mkostrun/QWERTY/art/cupwheel_1_original/PICT0091.jpg

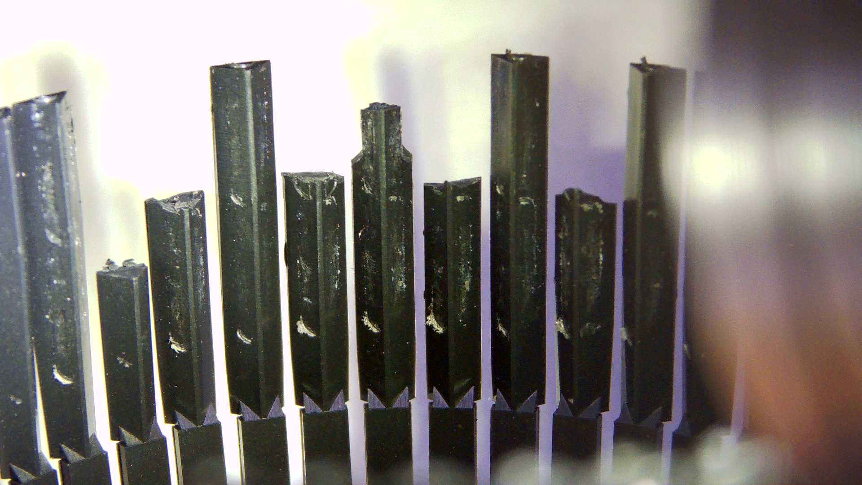
art/cupwheel_1_original/PICT0091.jpg
