mkostrun/QWERTY/art/stm32f030_Nucleo_64_Package_Drawing.jpg

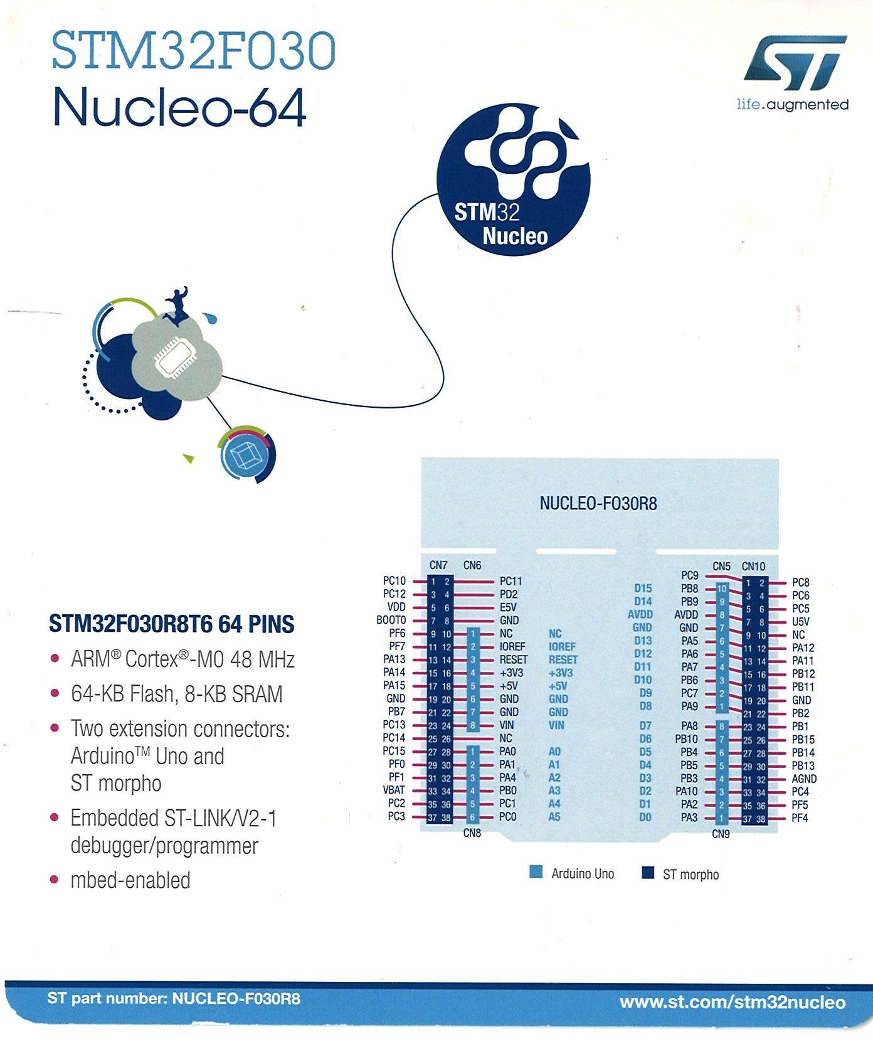
art/stm32f030_Nucleo_64_Package_Drawing.jpg
