mkostrun/QWERTY/art/cupwheel_1_original/PICT0086.jpg

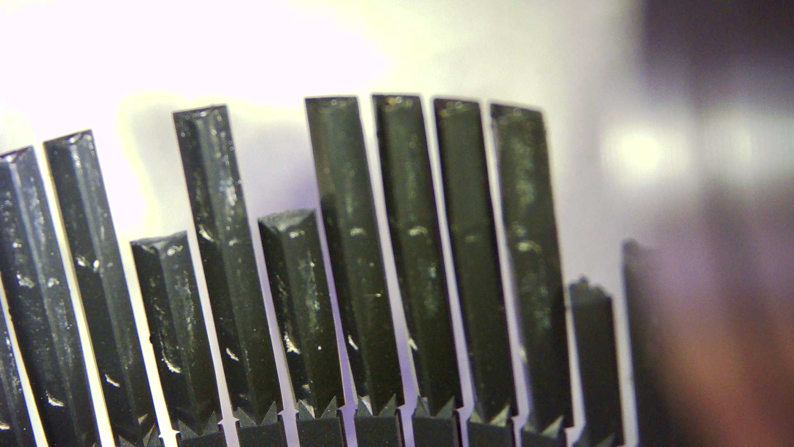
art/cupwheel_1_original/PICT0086.jpg
