mkostrun/QWERTY/art/cupwheel_1_original/PICT0087.jpg

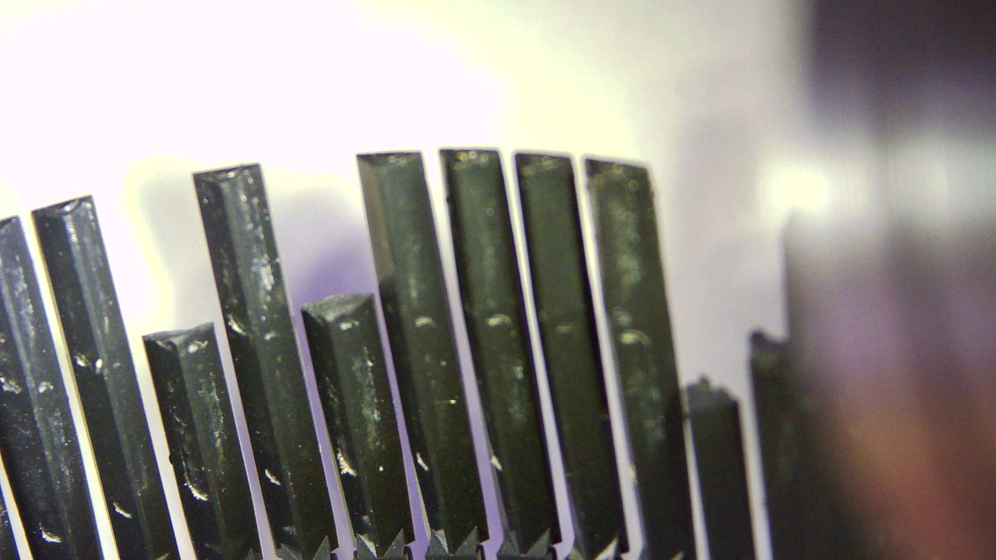
art/cupwheel_1_original/PICT0087.jpg
