mkostrun/QWERTY/art/cupwheel_1_original/PICT0088.jpg

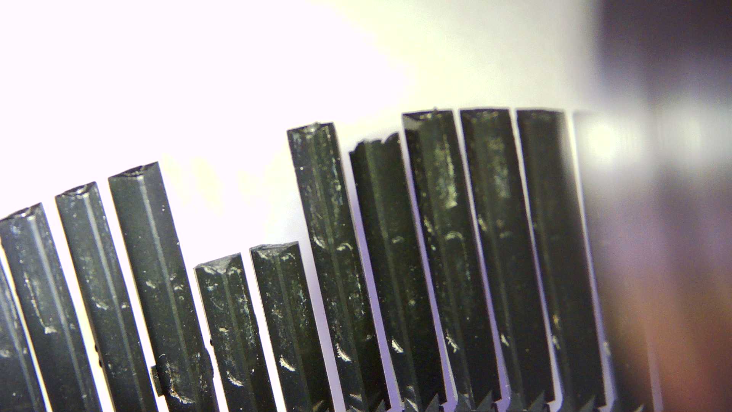
art/cupwheel_1_original/PICT0088.jpg
