mkostrun/QWERTY/art/cupwheel_1_original/PICT0089.jpg

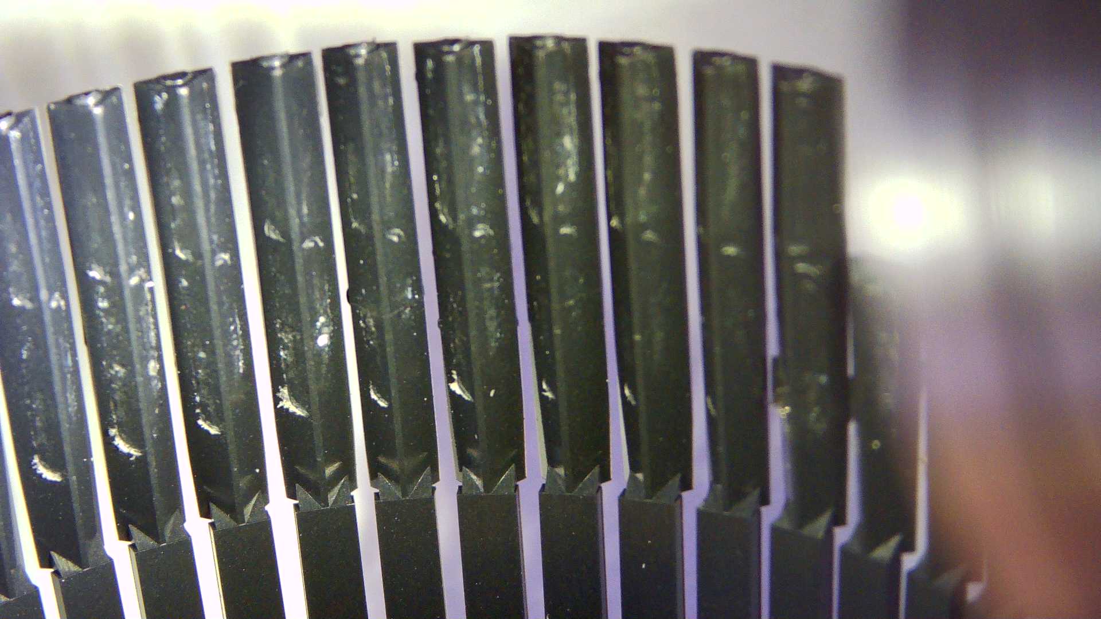
art/cupwheel_1_original/PICT0089.jpg
