mkostrun/QWERTY/art/cupwheel_1_original/PICT0090.jpg

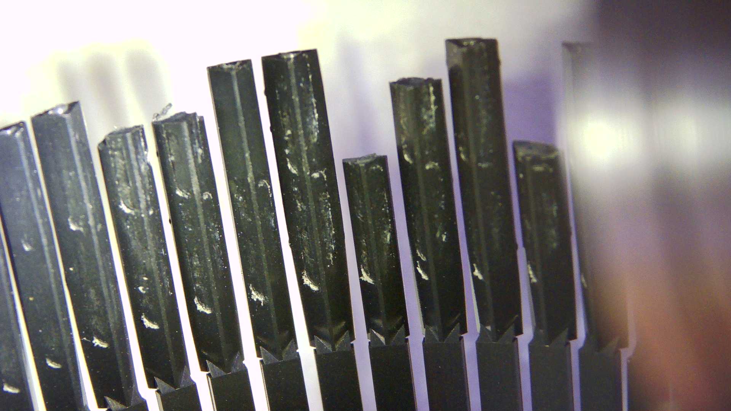
art/cupwheel_1_original/PICT0090.jpg
