mkostrun/QWERTY/art/cupwheel_2_from_goodwill_milwaukee/PICT0085.jpg

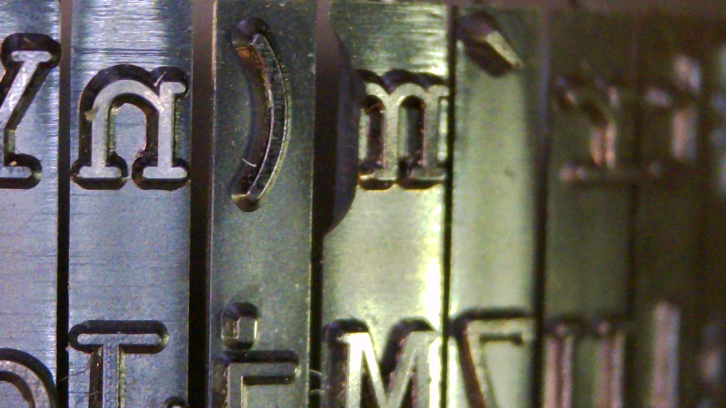
art/cupwheel_2_from_goodwill_milwaukee/PICT0085.jpg
