mkostrun/QWERTY/art/stm32f030_Nucleo_64_Package_Drawing-scaled-with_cable_header.png

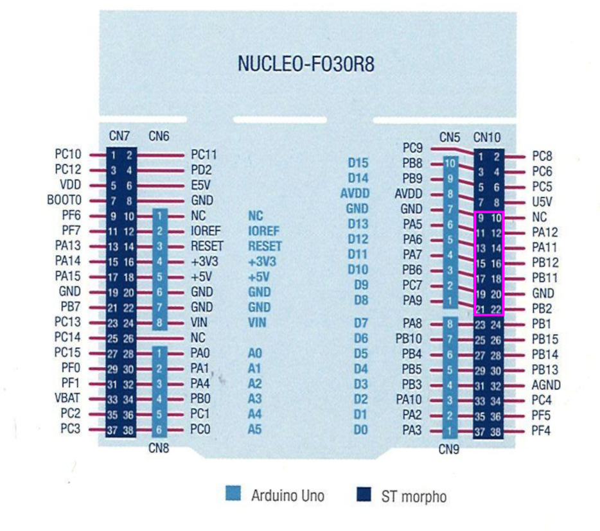
art/stm32f030_Nucleo_64_Package_Drawing-scaled-with_cable_header.png
