mkostrun/QWERTY/ibm-wheelwriter_1000/2026-07-17-IBM-WW1000-Pitch_Switch-v1-0.png

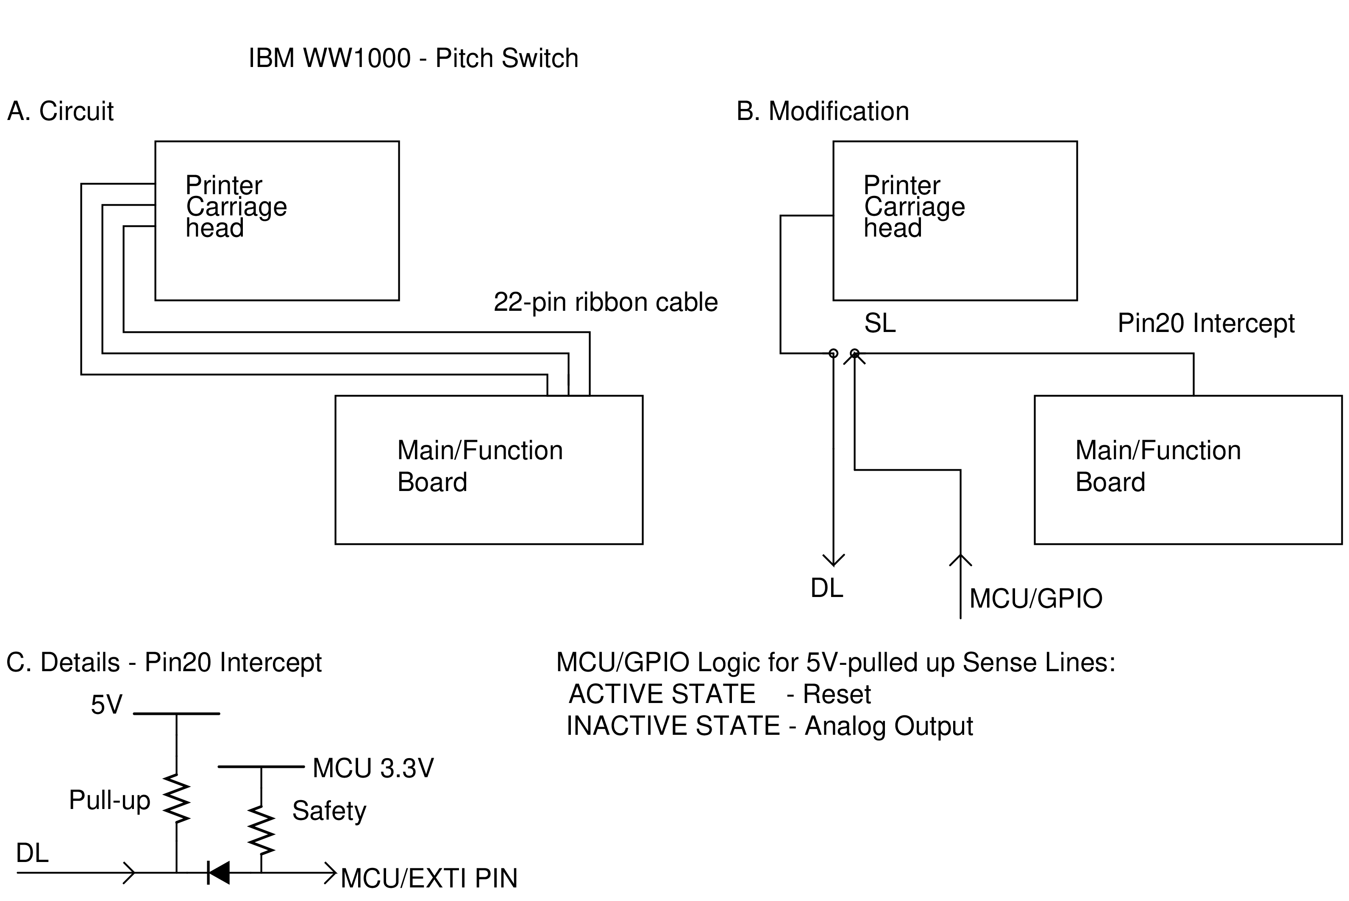
ibm-wheelwriter_1000/2026-07-17-IBM-WW1000-Pitch_Switch-v1-0.png
