mkostrun/QWERTY/lp/test-delta_and_gamma-formatted.txt

\x1bM
Date: May 5th, 2031
To whom it concerns,\x1bP\x1ba3
\x1b\x45Delta\x1b\x46 and \x1b\x45Gamma\x1b\x46 Functions were late to task today because they had their real analysts appointments in the morning 8.30-9.30am.
Signed,\x1b-1                   \x1b-0.
Mr. Complex Analyst, their supervisor
