mkostrun/QWERTY/ibm-wheelwriter_1000/f030r8-qwerty-ibm-ww1000-07-pitch_brute_force/Core/Src/main.c

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
/* Includes ------------------------------------------------------------------*/
#include "main.h"

const int32_t qwerty_pulse_ccr_drive[]=
{
  /* 0,7 */      1,
  /* 1,8 */   2079 - 100,
  /* 2,9 */   4051 - 100,
  /* 3,a */   6023 - 100,
  /* 4,b */   7995 - 100,
  /* 5,c */   9967 - 100,
  /* 6,d */  11939 - 100,
  /* 7,  */  13911 - 100,
  /* 8,  */  15883 - 100,
  /* 9,  */  17855 - 100,
};

const int32_t qwerty_pulse_arr_drive[]=
{
  /* 0,7 */  5748 + 1000,
  /* 1,8 */  9767 - 1000,
  /* 2,9 */ 11739 - 1000,
  /* 3,a */ 13711 - 1000,
  /* 4,b */ 15683 - 1000,
  /* 5,c */ 17655 - 1000,
  /* 6,d */ 19627 - 1000,
  /* 7,  */ 21599 - 1000,
  /* 8,  */ 23571 - 1000,
  /* 9,  */ 25543 - 1000,
};

const int32_t qwerty_pulse_arr2_drive[]=
{
  /* 0,7 */   1916,
  /* 1,8 */   3856,
  /* 2,9 */   5828,
  /* 3,a */   7800,
  /* 4,b */   9772,
  /* 5,c */  11744,
  /* 6,d */  13716,
  /* 7,  */  15688,
  /* 8,  */  17660,
  /* 9,  */  19632,
};

volatile uint32_t qwerty_output_counter_new;
volatile uint32_t qwerty_output_counter_default;
volatile uint32_t qwerty_output_counter1;
volatile uint32_t qwerty_output_counter2;
volatile uint32_t qwerty_output_counter3;
volatile uint8_t  qwerty_output_counter1_have_update;
volatile uint8_t  qwerty_output_counter2_have_update;
volatile uint8_t  qwerty_output_counter3_have_update;
volatile uint8_t  qwerty_typing = 0;
volatile uint32_t qwerty_pitch_rising_edge_counter;
volatile uint8_t  qwerty_pitch_set;
volatile uint8_t *qwerty_pitch_ptr;
const uint8_t     qwerty_pitch_bits_10p[] = {0,0,0,0};
const uint8_t     qwerty_pitch_bits_12p[] = {1,1,1,1};
const uint8_t     qwerty_pitch_bits_15p[] = {0,1,1,0};
const uint8_t     qwerty_pitch_bits_PSp[] = {1,0,0,1};

volatile uint8_t   idx_code_ch=0;
volatile uint8_t   idx_shift_ch=0;
volatile uint8_t   idx_drive_ch=0;
volatile uint8_t   idx_drive_ch_new=0;
volatile uint8_t   idx_sense_ch=0xff;
volatile uint8_t   idx_sense_ch_new=0xff;
volatile uint8_t   shift_first=0;
volatile uint8_t   code_first=0;

uint16_t idx_cmd=0, len_cmd=0;
int32_t  rcv_byte;
uint32_t new_pwm_period, new_pwm_pulse;
char msg[256];
data symbol1;

// private variables for parsing esc codes:
uint8_t iwait_esc_lmar        = 0;
uint8_t iwait_esc_rmar        = 0;
uint8_t iwait_esc_underline   = 0;
uint8_t iwait_esc_just        = 0;
uint8_t iwait_esc_par_indent  = 0;
uint8_t iwait_esc_tab_set     = 0;
uint8_t iwait_esc_term_set     = 0;

// private variables that determine the state of typewriter :
int16_t qwerty_page_lmar;
int16_t qwerty_page_rmar;

void SystemClock_Config(void);
static void MX_DMA_Init(void);

/* USER CODE BEGIN PFP */
//volatile int8_t qwerty_state = QWERTY_STATE_QUERY;
// volatile int8_t qwerty_state = QWERTY_STATE_WHISPER;
/* USER CODE END PFP */

/**
  * @brief  The application entry point.
  * @retval int
  */
int main(void)
{
  /**
    Init typewriter variables
    */
  // symbol[0].val = 0x0027;

  /**
   * TIM3 OUTPUT CAPTURE MODE USING
   *                INPUTS:
   *                    CH3 <=> PC8
   *                      TO_EDGE1 INTERRUPT CREATES SOFTWARE TRIGGER FOR TIM14/ONE PULSE MODE
   *                    CH4 <=> PC9
   * TO_EDGE1 TRANSITION:
   *   TIM3_OC_MODE_POSITIVE QWERTY_MODE_POSITIVE
   *   TIM3_OC_MODE_INVERTED QWERTY_MODE_INVERTED
   **/
  qwerty_tim3_oc_mode = QWERTY_MODE_INVERTED;
  // qwerty_tim3_oc_mode = QWERTY_MODE_POSITIVE;

  /**
   * GPIO/MUX MODE:
   *   MUX_IT_MODE_POSITIVE QWERTY_MODE_POSITIVE
   *   MUX_IT_MODE_INVERTED QWERTY_MODE_INVERTED
   **/
  mux_it_mode           = QWERTY_MODE_INVERTED;
  // mux_it_mode           = QWERTY_MODE_POSITIVE;

  // timers: 1clock = 48MHz/20 = 2.4Mhz <-> 0.4166 us,
  qwerty_tim_base_prescaler   = 20;

  qwerty_typewriter_system_state = QWERTY_TYPEWRITER_SYSTEM_STATE_DEFAULT;

_restart:

  // TIM3: output capture
  if (qwerty_tim3_oc_mode == TIM3_OC_MODE_POSITIVE)
  {
    qwerty_tim3_oc_it_edge_lead  = TIM_INPUTCHANNELPOLARITY_RISING;
    qwerty_tim3_oc_it_edge_trail = TIM_INPUTCHANNELPOLARITY_FALLING;
  }
  else
  {
    qwerty_tim3_oc_it_edge_lead  = TIM_INPUTCHANNELPOLARITY_FALLING;
    qwerty_tim3_oc_it_edge_trail = TIM_INPUTCHANNELPOLARITY_RISING;
  }

  edge1 = 0;
  edge2 = 0;
  previous_IC_Value1 = IC_Value1 = 0;
  previous_IC_Value2 = IC_Value2 = 0;
  period1 = 0;
  pulse1  = 0;
  period2 = 0;
  pulse2  = 0;
  delay2  = 0;
  qwerty_output_counter_default       = QWERTY_OUTPUT_COUNTER_DEFAULT;
  qwerty_output_counter_new           = 0;
  qwerty_output_counter1              = 0;
  qwerty_output_counter2              = 0;
  qwerty_output_counter1_have_update  = 0;
  qwerty_output_counter2_have_update  = 0;
  qwerty_pitch_rising_edge_counter    = 0;
  qwerty_pitch_set = 0;
  qwerty_pitch_ptr = (uint8_t *) qwerty_pitch_bits_12p;
  idx_code_ch=0;
  idx_shift_ch=0;
  idx_drive_ch=0;
  idx_drive_ch_new=0;
  idx_sense_ch=0xff;
  idx_sense_ch_new=0xff;
  shift_first = 0;
  code_first = 0;

  mux_it_edge = 0;
  if (mux_it_mode == QWERTY_MODE_INVERTED)
  {
    mux_it_mode_gpio_pin_edge0_state = GPIO_PIN_SET;
    mux_it_mode_gpio_pin_edge1_state = GPIO_PIN_RESET;
  }
  else
  {
    mux_it_mode_gpio_pin_edge0_state = GPIO_PIN_RESET;
    mux_it_mode_gpio_pin_edge1_state = GPIO_PIN_SET;
  }


  /* USER CODE END 1 */
  qwerty_count_typewriter_base_pulses_after_last_printed_character = 0;

  /* MCU Configuration--------------------------------------------------------*/

  /* Reset of all peripherals, Initializes the Flash interface and the Systick. */
  HAL_Init();

  /* Configure the system clock */
  SystemClock_Config();

  /* Initialize all configured peripherals */
  MX_GPIO_Init();
  MX_DMA_Init();
  MX_USART2_UART_Init();
  MX_TIM3_Init();
  MX_TIM14_Init();
  MX_TIM17_Init();

  /* USER CODE BEGIN 2 */
  HAL_TIM_IC_Start_IT (&htim3, TIM_CHANNEL_1);
  HAL_TIM_IC_Start_IT (&htim3, TIM_CHANNEL_2);

  HAL_UART_Receive_DMA (&huart2, usart2_rx_dma_buffer, USART2_RX_DMA_BUFFER_SIZE);
  /* USER CODE END 2 */

  qwerty_count_typewriter_base_pulses = 0;
  qwerty_count_typewriter_base_pulses_after_last_printed_character = 0;
  qwerty_count_typed_characters = 0;

  // initialize typewriter output state variables and counters
  qwerty_output_buffer_start          = 0;
  qwerty_output_buffer_end            = 0;
  qwerty_output_buffer_bold           = 0;
  qwerty_output_buffer_underline      = 0;
  qwerty_output_buffer_line_spacing   = 0;
  qwerty_output_buffer_kbd_2          = 0;
  qwerty_output_buffer_mode           = 0;
  qwerty_output_buffer_esc_received   = 0;
  qwerty_output_buffer_null_received  = 0;
  qwerty_output_buffer_just           = 0;
  idx_shift_ch                        = 0;

  int16_t qwerty_page_lmar = -1;
  int16_t qwerty_page_rmar = -1;

  print_serial("QWERTY FIRMWARE " TYPEWRITER_FIRMWARE_VERSION " : ");
  if ( (qwerty_tim3_oc_mode   == QWERTY_MODE_INVERTED)
    && (mux_it_mode           == QWERTY_MODE_INVERTED) )
  {
    print_serial("MODE: INV: ");
  }

  if ( (qwerty_tim3_oc_mode   == QWERTY_MODE_POSITIVE)
    && (mux_it_mode           == QWERTY_MODE_POSITIVE) )
  {
    print_serial("MODE: POS: ");
  }
  if (qwerty_typewriter_system_state == QWERTY_TYPEWRITER_SYSTEM_STATE_CLI)
  {
    print_serial("BEGIN: CLI\r\n");
  }
  else
  {
    print_serial("BEGIN: TYPEWRITER\r\n");
  }

#if 0
  for (idx_drive_ch_new=0;idx_drive_ch_new<14;idx_drive_ch_new++)
  {
    qwerty_tim14_oc_ccr =
    (idx_drive_ch_new == 0 ? 1           : TIM14_CCR + 38 + 125 + TIM14_PULSE * (idx_drive_ch_new - 1));
    // The first and the last pulse in the sequence have extra length: debouncing algorithm
    qwerty_tim14_oc_arr =
    (idx_drive_ch_new == 0 ? 3*TIM14_CCR : TIM14_CCR - 16 - 21 + TIM14_PULSE * (idx_drive_ch_new + 3));
    // In between pulses are of normal length
    qwerty_tim14_oc_arr2 =
    (idx_drive_ch_new == 0 ?   TIM14_CCR : TIM14_CCR - 16 - 16 + TIM14_PULSE * (idx_drive_ch_new ));
    sprintf(msg,"TIM14: %1x: ccr=%5i arr=%5i arr2=%5i\r\n", idx_drive_ch_new,
            qwerty_tim14_oc_ccr, qwerty_tim14_oc_arr, qwerty_tim14_oc_arr2);
    print_serial(msg);
  }
#endif

  /* USER CODE BEGIN WHILE */
  while (1)
  {
    //
    // keep processing OUTPUT buffer
    //
    if (qwerty_output_buffer_end != qwerty_output_buffer_start)
      if (!qwerty_typing)
    {
      qwerty_typing = 1;

      qwerty_output_counter1             = 0;
      qwerty_output_counter2             = 0;
      qwerty_output_counter1_have_update = 0;
      qwerty_output_counter2_have_update = 0;

      // unsupported bit is used to pass pause after sending pitch reset commands
      if (qwerty_output_buffer[qwerty_output_buffer_start].val & KEYBOARD_UNSUPPORTED)
      {
        qwerty_typing = 0;
        qwerty_pitch_set = 0;
        HAL_Delay( (qwerty_output_buffer[qwerty_output_buffer_start].val & 0x7fff) );
        INC_BUFFER_IDX(qwerty_output_buffer_start, 1);
        continue;
      }

      idx_drive_ch_new = qwerty_output_buffer[qwerty_output_buffer_start].symbol.drive;
      idx_sense_ch_new = qwerty_output_buffer[qwerty_output_buffer_start].symbol.sense;
      idx_code_ch      = qwerty_output_buffer[qwerty_output_buffer_start].symbol.code;
      idx_shift_ch     = qwerty_output_buffer[qwerty_output_buffer_start].symbol.shift;
      INC_BUFFER_IDX(qwerty_output_buffer_start, 1);

      qwerty_count_typed_characters++;

      uint8_t idx_drive = idx_drive_ch_new;
      if (idx_drive > (QWERTY_INDEX_DRIVE_SPLIT-1))
      {
        //idx_drive -= 7; /* this one doesnt change: it is fixed at 7 */
        idx_drive -= 4; /* this one doesnt change: it is fixed at 4: CODE */
      }
      idx_drive--; /* we changed the trigger from trailing edge of D0-shift/D4-code */

      qwerty_tim14_oc_ccr  = qwerty_pulse_ccr_drive [idx_drive];
      qwerty_tim14_oc_arr  = qwerty_pulse_arr_drive [idx_drive];
      qwerty_tim14_oc_arr2 = qwerty_pulse_arr2_drive[idx_drive];

      qwerty_pitch_rising_edge_counter = 0;

      if (idx_drive_ch_new > (QWERTY_INDEX_DRIVE_SPLIT-1))
      {
        shift_first = idx_shift_ch;

        code_first = 0;
        if (idx_code_ch) idx_code_ch = 2;

        qwerty_output_counter2_have_update = 1;
      } /* (idx_drive_ch_new > (QWERTY_INDEX_DRIVE_SPLIT-1)) )*/
      else
      {
        shift_first = 0;
        if (idx_shift_ch) idx_shift_ch = 2;

        code_first = idx_code_ch;

        qwerty_output_counter1_have_update = 1;
      } /* (idx_drive_ch_new > (QWERTY_INDEX_DRIVE_SPLIT-1)) )*/

      while (qwerty_typing){;}

    } /*if (qwerty_output_buffer_end != qwerty_output_buffer_start) if (!qwerty_typing)*/

    //
    //  get character from serial port
    //
    rcv_byte = __io_getchar();

    //
    //  stop here if nothing was received
    //
    if (rcv_byte < 0)
    {
      continue;
    }

    if (qwerty_typewriter_system_state == QWERTY_TYPEWRITER_SYSTEM_STATE_TYPEWRITER)
    {
      // receiving two 0x00 bytes switches typewriter mode off and back to command line
      if (rcv_byte == 0x00)
      {
        if (!qwerty_output_buffer_null_received)
        {
          qwerty_output_buffer_null_received = 1;
        }
        else
        {
          qwerty_typewriter_system_state = QWERTY_TYPEWRITER_SYSTEM_STATE_CLI;
          qwerty_output_buffer_null_received = 0;
        }
        continue;
      }

      qwerty_output_buffer_null_received = 0;

      if (rcv_byte == 0x1b)
      {
        //
        // ESC -received
        //
        qwerty_output_buffer_esc_received = 1;
        continue;
      }

      if (qwerty_output_buffer_esc_received == 1)
      {
        /* failed to recognize ESC code */
        qwerty_output_buffer_esc_received = 0;

        /** Escape sequence:
         *   ESC 0      -> line spacing 1
         *   ESC 1      -> line spacing 1-1/2
         *   ESC 2      -> line spacing 2
         *   ESC 3      -> line spacing 3
         *   ESC - 0/1  -> set underline on/off
         *   ESC Q n    -> set right margin to n
         *   ESC l m    -> set left  margin to m
         *   ESC i 0/1  -> paragraph indent on/off
         */
        if (rcv_byte == '?')
        {
          sprintf(msg, "pitch %i\r\n", qwerty_pitch_rising_edge_counter);
          print_serial(msg);
          qwerty_pitch_rising_edge_counter = 0;
        }
        else if (rcv_byte == 0x7f)
        {
          //
          // ESC+BS received
          //
          qwerty_output_buffer[qwerty_output_buffer_end].val = 0x00c2 | KEYBOARD_CODE;
          INC_BUFFER_IDX(qwerty_output_buffer_end,1);
          continue;
        }
        else if (rcv_byte == '0')
        {
          /* ESC 0 - Line Spacing 1 */
          while (qwerty_output_buffer_line_spacing != 0)
          {
            qwerty_output_buffer[qwerty_output_buffer_end].val = 0x0011 | KEYBOARD_CODE;
            INC_BUFFER_IDX(qwerty_output_buffer_end,1);
            qwerty_output_buffer_line_spacing
              = (qwerty_output_buffer_line_spacing + 1) % qwerty_state_line_spacing_limit;
          }
          qwerty_output_buffer_line_spacing = 0;
        }
        else if (rcv_byte == '1')
        {
          /* ESC 1 - Line Spacing 1 1/2*/
          while (qwerty_output_buffer_line_spacing != 1)
          {
            qwerty_output_buffer[qwerty_output_buffer_end].val = 0x0011 | KEYBOARD_CODE;
            INC_BUFFER_IDX(qwerty_output_buffer_end,1);
            qwerty_output_buffer_line_spacing
                = (qwerty_output_buffer_line_spacing + 1) % qwerty_state_line_spacing_limit;
          }
          qwerty_output_buffer_line_spacing = 1;
        }
        else if (rcv_byte == '2')
        {
          /* ESC 2 - Line Spacing 2*/
          while (qwerty_output_buffer_line_spacing != 2)
          {
            qwerty_output_buffer[qwerty_output_buffer_end].val = 0x0011 | KEYBOARD_CODE;
            INC_BUFFER_IDX(qwerty_output_buffer_end,1);
            qwerty_output_buffer_line_spacing
                = (qwerty_output_buffer_line_spacing + 1) % qwerty_state_line_spacing_limit;
          }
          qwerty_output_buffer_line_spacing = 2;
        }
        else if (rcv_byte == '3')
        {
          /* ESC 3 - Line Spacing 3*/
          while (qwerty_output_buffer_line_spacing != 3)
          {
            qwerty_output_buffer[qwerty_output_buffer_end].val = 0x0011 | KEYBOARD_CODE;
            INC_BUFFER_IDX(qwerty_output_buffer_end,1);
            qwerty_output_buffer_line_spacing
                = (qwerty_output_buffer_line_spacing + 1) % qwerty_state_line_spacing_limit;
          }
          qwerty_output_buffer_line_spacing = 3;
        }
        else if (rcv_byte == 'P')
        {
          // PICA, aka 10 CPI pitch
          // qwerty_output_buffer[qwerty_output_buffer_end].val = 0x00a3 | KEYBOARD_CODE;
          // INC_BUFFER_IDX(qwerty_output_buffer_end,1);
          // qwerty_pitch_ptr = qwerty_pitch_bits_10p;
          qwerty_output_buffer_font_pitch = 0;
          // qwerty_pitch_rising_edge_counter = 0;
          // qwerty_pitch_set = 1;
        }
        else if (rcv_byte == 'M')
        {
          // elite, aka 12 CPI pitch
          // qwerty_output_buffer[qwerty_output_buffer_end].val = 0x00a3 | KEYBOARD_CODE;
          // INC_BUFFER_IDX(qwerty_output_buffer_end,1);
          // qwerty_pitch_ptr = qwerty_pitch_bits_12p;
          qwerty_output_buffer_font_pitch = 1;
          // qwerty_pitch_set = 1;
        }
        else if ((rcv_byte == 0X0F)||(rcv_byte == 'O'))
        {
          // CONDENSED, aka 15 CPI
          // qwerty_output_buffer[qwerty_output_buffer_end].val = 0x00a3 | KEYBOARD_CODE;
          // INC_BUFFER_IDX(qwerty_output_buffer_end,1);
          // qwerty_pitch_ptr = qwerty_pitch_bits_15p;
          qwerty_output_buffer_font_pitch = 2;
          // qwerty_pitch_rising_edge_counter = 0;
          // qwerty_pitch_set = 1;
        }
        // else if (rcv_byte == 'p')
        // {
        //   // PROPORTIONAL SCRIPT, aka ps
        //   // CODE+9
        //   // qwerty_output_buffer[qwerty_output_buffer_end].val = 0x00a3 | KEYBOARD_CODE;
        //   // INC_BUFFER_IDX(qwerty_output_buffer_end,1);
        //
        //   // Sequence: CODE + {l,0,0,1}
        //   // CODE + l
        //   qwerty_output_buffer[qwerty_output_buffer_end].val = 0x00a1 | KEYBOARD_CODE;
        //   INC_BUFFER_IDX(qwerty_output_buffer_end,1);
        //   // CODE + 0
        //   qwerty_output_buffer[qwerty_output_buffer_end].val = 0x00b3 | KEYBOARD_CODE;
        //   INC_BUFFER_IDX(qwerty_output_buffer_end,1);
        //   // CODE + 0
        //   qwerty_output_buffer[qwerty_output_buffer_end].val = 0x00b3 | KEYBOARD_CODE;
        //   INC_BUFFER_IDX(qwerty_output_buffer_end,1);
        //   // CODE + 1
        //   qwerty_output_buffer[qwerty_output_buffer_end].val = 0x0023 | KEYBOARD_CODE;
        //   INC_BUFFER_IDX(qwerty_output_buffer_end,1);
        //   // use unsupported for passing pause duration after pitch adjustment
        //   qwerty_output_buffer[qwerty_output_buffer_end].val = (400 && 0xffff) | KEYBOARD_UNSUPPORTED;
        //   INC_BUFFER_IDX(qwerty_output_buffer_end,1);
        //
        //   qwerty_pitch_ptr = qwerty_pitch_bits_PSp;
        //
        //   qwerty_output_buffer_font_pitch = 3;
        //   qwerty_pitch_rising_edge_counter = 0;
        //   qwerty_pitch_set = 1;
        // }
        else if (rcv_byte == 'o')
        {
          // CODE+9
          // qwerty_output_buffer[qwerty_output_buffer_end].val = 0x00a3 | KEYBOARD_CODE;
          // INC_BUFFER_IDX(qwerty_output_buffer_end,1);

          // Sequence: CODE + {l,0,0,1}
          // CODE + l
          qwerty_output_buffer[qwerty_output_buffer_end].val = 0x00a1 | KEYBOARD_CODE;
          INC_BUFFER_IDX(qwerty_output_buffer_end,1);
          // CODE + 0
          qwerty_output_buffer[qwerty_output_buffer_end].val = 0x00b3 | KEYBOARD_CODE;
          INC_BUFFER_IDX(qwerty_output_buffer_end,1);
          // CODE + 0
          qwerty_output_buffer[qwerty_output_buffer_end].val = 0x00b3 | KEYBOARD_CODE;
          INC_BUFFER_IDX(qwerty_output_buffer_end,1);
          // CODE + 1
          qwerty_output_buffer[qwerty_output_buffer_end].val = 0x0023 | KEYBOARD_CODE;
          INC_BUFFER_IDX(qwerty_output_buffer_end,1);
          // use unsupported for passing pause duration after pitch adjustment
          qwerty_output_buffer[qwerty_output_buffer_end].val = (400 && 0xffff) | KEYBOARD_UNSUPPORTED;
          INC_BUFFER_IDX(qwerty_output_buffer_end,1);
          // CODE+9
          // qwerty_output_buffer[qwerty_output_buffer_end].val = 0x00a3 | KEYBOARD_CODE;
          // INC_BUFFER_IDX(qwerty_output_buffer_end,1);

          qwerty_pitch_ptr = qwerty_pitch_bits_10p;

          qwerty_output_buffer_font_pitch = 3;
          qwerty_pitch_rising_edge_counter = 0;
          qwerty_pitch_set = 2;
        }
        else if (rcv_byte == 'z')
        {
          // CODE+shift+TSet
          qwerty_output_buffer[qwerty_output_buffer_end].val = 0x00d1 | KEYBOARD_CODE | KEYBOARD_SHIFT;
          INC_BUFFER_IDX(qwerty_output_buffer_end,1);

          qwerty_pitch_ptr = qwerty_pitch_bits_10p;

          qwerty_output_buffer_font_pitch = 3;
          qwerty_pitch_rising_edge_counter = 0;
          qwerty_pitch_set = 1;
        }
        else if (rcv_byte == 's')
        {
          // PROPORTIONAL SCRIPT, aka ps
          // CODE+9
          qwerty_output_buffer[qwerty_output_buffer_end].val = 0x00a3 | KEYBOARD_CODE;
          INC_BUFFER_IDX(qwerty_output_buffer_end,1);

          // use unsupported for passing pause duration after pitch adjustment
          qwerty_output_buffer[qwerty_output_buffer_end].val = (200 && 0xffff) | KEYBOARD_UNSUPPORTED;
          INC_BUFFER_IDX(qwerty_output_buffer_end,1);

          qwerty_pitch_rising_edge_counter = 0;
          qwerty_pitch_set = 1;
        }
        else if ((rcv_byte == 'E') || (rcv_byte == 'G'))
        {
          // toggle bold if OFF
          if (!qwerty_output_buffer_bold)
          {
            qwerty_output_buffer[qwerty_output_buffer_end].val = 0x0077 | KEYBOARD_CODE;
            INC_BUFFER_IDX(qwerty_output_buffer_end,1);
            qwerty_output_buffer_bold = 1;
          }
        }
        else if ((rcv_byte == 'F') || (rcv_byte == 'H'))
        {
          // toggle bold if ON
          if (qwerty_output_buffer_bold)
          {
            qwerty_output_buffer[qwerty_output_buffer_end].val = 0x0077 | KEYBOARD_CODE;
            INC_BUFFER_IDX(qwerty_output_buffer_end,1);
            qwerty_output_buffer_bold = 0;
          }
        }
        else if (rcv_byte == '-') /* underline  */
        {
          iwait_esc_underline = 1;
          qwerty_output_buffer_esc_received = 2;
        }
        else if (rcv_byte == 'l') /* l margin n */
        {
          iwait_esc_lmar      = 1;
          qwerty_output_buffer_esc_received = 2;
        }
        else if (rcv_byte == 'Q') /* r margin n */
        {
          iwait_esc_rmar      = 1;
          qwerty_output_buffer_esc_received = 2;
        }
        else if (rcv_byte == 'D') /* Horizontal tabs setup */
        {
          iwait_esc_tab_set = 1;
          qwerty_output_buffer_esc_received = 2;
        }
        else if (rcv_byte == '[') /* escape terminal codes */
        {
          iwait_esc_term_set = 1;
          qwerty_output_buffer_esc_received = 2;
        }
        else if (rcv_byte == 'i') /* paragraph indent */
        {
          iwait_esc_par_indent = 1;
          qwerty_output_buffer_esc_received = 2;
        }
        else if (rcv_byte == 'a') /* Justification n */
        {
          iwait_esc_just      = 1;
          qwerty_output_buffer_esc_received = 2;
        }

        continue;
      } /* if (qwerty_output_buffer_esc_received == 1) */

      if (qwerty_output_buffer_esc_received == 2)
      {
        /* failed to recognize ESC code */
        qwerty_output_buffer_esc_received = 0;

        if (iwait_esc_term_set)
        {
          if (iwait_esc_term_set == 1)
          {
            iwait_esc_term_set = 0;

            if (rcv_byte == 'A')
            {
              // UP
              qwerty_output_buffer[qwerty_output_buffer_end].val = 0x00c6;
              INC_BUFFER_IDX(qwerty_output_buffer_end,1);
            }
            else if (rcv_byte == 'B')
            {
              // DOWN
              qwerty_output_buffer[qwerty_output_buffer_end].val = 0x0010;
              INC_BUFFER_IDX(qwerty_output_buffer_end,1);
            }
            else if (rcv_byte == 'C')
            {
              // RIGHT
              qwerty_output_buffer[qwerty_output_buffer_end].val = 0x0017;
              INC_BUFFER_IDX(qwerty_output_buffer_end,1);
            }
            else if (rcv_byte == 'D')
            {
              // LEFT
              qwerty_output_buffer[qwerty_output_buffer_end].val = 0x00C7;
              INC_BUFFER_IDX(qwerty_output_buffer_end,1);
            }
            else if (rcv_byte == '3')
            {
              // is it DEL?
              iwait_esc_term_set = 3;
              qwerty_output_buffer_esc_received = 3;
            }
          }

          continue;
        }

        if (iwait_esc_tab_set)
        {
          iwait_esc_tab_set = 0;

          if ((rcv_byte == '0') || (rcv_byte == 0))
          {
            // press TAB CLR to clear all tabs
            qwerty_output_buffer[qwerty_output_buffer_end].val = 0x0030;
            INC_BUFFER_IDX(qwerty_output_buffer_end,1);
            qwerty_output_buffer_tab_set = 0;
          }
          else if ((rcv_byte == '1') || (rcv_byte == 1))
          {
            // press TAB SET at the current position of the carriage
            qwerty_output_buffer[qwerty_output_buffer_end].val = 0x00d1;
            INC_BUFFER_IDX(qwerty_output_buffer_end,1);
            qwerty_output_buffer_tab_set ++;
          }

          continue;
        } /* if (iwait_esc_tab_set) */

        if (iwait_esc_rmar)
        {
          iwait_esc_rmar = 0;

          // if new and old value are the same: nothing to do
          // or if left margin is greater than new right margin: reject change
          if ((qwerty_page_rmar == rcv_byte) || (qwerty_page_lmar > rcv_byte))
          {
            continue;
          }

          // lmar has not been setup yet
          if (qwerty_page_lmar < 0)
          {
            // MAR REL
            qwerty_output_buffer[qwerty_output_buffer_end].val = 0x00d2;
            INC_BUFFER_IDX(qwerty_output_buffer_end,1);

            /* go back and delete left margin */
            for (int8_t i=0; i<84; i++)
            {
              // BS
              qwerty_output_buffer[qwerty_output_buffer_end].val = 0x00c2;
              INC_BUFFER_IDX(qwerty_output_buffer_end,1);

            }
            // set L margin at 0
            qwerty_output_buffer[qwerty_output_buffer_end].val = 0x0034;
            INC_BUFFER_IDX(qwerty_output_buffer_end,1);

            // store internally L margin as 0
            qwerty_page_lmar = 0;
          }
          else
          {
            // press enter to get to the current left margin
            qwerty_output_buffer[qwerty_output_buffer_end].val = 0x00c0;
            INC_BUFFER_IDX(qwerty_output_buffer_end,1);

            // press rev index to go back up to the current line
            for (int8_t i=0; i<2+qwerty_output_buffer_line_spacing; i++)
            {
              qwerty_output_buffer[qwerty_output_buffer_end].val = 0x00c6;
              INC_BUFFER_IDX(qwerty_output_buffer_end,1);
            }
          }

          // MAR REL
          qwerty_output_buffer[qwerty_output_buffer_end].val = 0x00d2;
          INC_BUFFER_IDX(qwerty_output_buffer_end,1);
          /* go right m places */
          for (uint8_t i=0; i<rcv_byte-qwerty_page_lmar; i++)
          {
            // space
            qwerty_output_buffer[qwerty_output_buffer_end].val = 0x0037;
            INC_BUFFER_IDX(qwerty_output_buffer_end,1);
          }

          // set R margin
          qwerty_output_buffer[qwerty_output_buffer_end].val = 0x00d5;
          INC_BUFFER_IDX(qwerty_output_buffer_end,1);
          qwerty_page_rmar = rcv_byte;

          continue;
        } /* if (iwait_esc_rmar) */

        if (iwait_esc_lmar)
        {
          iwait_esc_lmar = 0;

          if (qwerty_page_lmar == rcv_byte)
          {
            continue;
          }

          // if left margin is greater than new right margin: reject change
          if ( (qwerty_page_rmar > 0) && (qwerty_page_rmar < rcv_byte) )
          {
            continue;
          }

          if (qwerty_page_lmar < 0)
          {
            // MAR REL
            qwerty_output_buffer[qwerty_output_buffer_end].val = 0x00d2;
            INC_BUFFER_IDX(qwerty_output_buffer_end,1);

            /* go back  */
            for (int8_t i=0; i<84; i++)
            {
              // BS
              qwerty_output_buffer[qwerty_output_buffer_end].val = 0x00c2;
              INC_BUFFER_IDX(qwerty_output_buffer_end,1);
            }

            /* go right m places */
            for (int8_t i=0; i<rcv_byte; i++)
            {
              // space
              qwerty_output_buffer[qwerty_output_buffer_end].val = 0x0037;
              INC_BUFFER_IDX(qwerty_output_buffer_end,1);
            }
          }
          else if (qwerty_page_lmar != rcv_byte)
          {
            // press enter to get to the current left margin
            qwerty_output_buffer[qwerty_output_buffer_end].val = 0x00c0;
            INC_BUFFER_IDX(qwerty_output_buffer_end,1);

            // press UP to go back up to the current line
            for (int8_t i=0; i<2+qwerty_output_buffer_line_spacing; i++)
            {
              qwerty_output_buffer[qwerty_output_buffer_end].val = 0x00c6;
              INC_BUFFER_IDX(qwerty_output_buffer_end,1);
            }

            if (rcv_byte > qwerty_page_lmar)
            {
              /* go right */
              for (int8_t i=0; i<rcv_byte-qwerty_page_lmar; i++)
              {
                // SPACE
                qwerty_output_buffer[qwerty_output_buffer_end].val = 0x0037;
                INC_BUFFER_IDX(qwerty_output_buffer_end,1);
              }
            }
            else
            {
              // MAR REL
              qwerty_output_buffer[qwerty_output_buffer_end].val = 0x00d2;
              INC_BUFFER_IDX(qwerty_output_buffer_end,1);

              /* go left and release left margin */
              for (int8_t i=0; i<qwerty_page_lmar-rcv_byte; i++)
              {
                // BS
                qwerty_output_buffer[qwerty_output_buffer_end].val = 0x00c2;
                INC_BUFFER_IDX(qwerty_output_buffer_end,1);
              }
            }
          }

          // set L margin
          qwerty_output_buffer[qwerty_output_buffer_end].val = 0x0034;
          INC_BUFFER_IDX(qwerty_output_buffer_end,1);
          // store internally L margin
          qwerty_page_lmar = rcv_byte;
          continue;
        } /* if (iwait_esc_lmar) */

        if (iwait_esc_par_indent)
        {
          iwait_esc_par_indent = 0;
          qwerty_output_buffer_esc_received = 0;

          if ( (rcv_byte == '0') || (rcv_byte == 0x00) )
          {
            // toggle par indent if ON
            if (qwerty_output_buffer_par_indent)
            {
              qwerty_output_buffer[qwerty_output_buffer_end].val = 0x00c0 | KEYBOARD_CODE;
              INC_BUFFER_IDX(qwerty_output_buffer_end,1);
              qwerty_output_buffer_par_indent = 0;
            }
          }
          else if ( (rcv_byte == '1') || (rcv_byte == 0x01) )
          {
            // toggle par indent if OFF
            if (!qwerty_output_buffer_par_indent)
            {
              qwerty_output_buffer[qwerty_output_buffer_end].val = 0x00d4 | KEYBOARD_CODE;
              INC_BUFFER_IDX(qwerty_output_buffer_end,1);
              qwerty_output_buffer_par_indent = 1;
            }
          }
        } /* if (iwait_esc_par_indent) */

        if (iwait_esc_underline)
        {
          iwait_esc_underline = 0;
          qwerty_output_buffer_esc_received = 0;

          if ( (rcv_byte == '0') || (rcv_byte == 0x00) )
          {
            // toggle underline if ON
            if (qwerty_output_buffer_underline)
            {
              qwerty_output_buffer[qwerty_output_buffer_end].val = 0x0084 | KEYBOARD_CODE;
              INC_BUFFER_IDX(qwerty_output_buffer_end,1);
              qwerty_output_buffer_underline = 0;
            }
          }
          else if ( (rcv_byte == '1') || (rcv_byte == 0x01) )
          {
            // toggle underline if OFF
            if (!qwerty_output_buffer_underline)
            {
              qwerty_output_buffer[qwerty_output_buffer_end].val = 0x0084 | KEYBOARD_CODE;
              INC_BUFFER_IDX(qwerty_output_buffer_end,1);
              qwerty_output_buffer_underline = 1;
            }
          }
        } /* if (iwait_esc_underline) */

        if (iwait_esc_just)
        {
          iwait_esc_just = 0;

          if (rcv_byte == '0')
          {
            // justification: none, user controlled
            if (qwerty_output_buffer_just == 1)
            {
              /* turn off center justification : press CODE + C */
              qwerty_output_buffer[qwerty_output_buffer_end].val = 0x0066 | KEYBOARD_CODE;
              INC_BUFFER_IDX(qwerty_output_buffer_end,1);
            }
            else if (qwerty_output_buffer_just == 2)
            {
              /* turn off right justification : press CODE + O */
              qwerty_output_buffer[qwerty_output_buffer_end].val = 0x00a4 | KEYBOARD_CODE;
              INC_BUFFER_IDX(qwerty_output_buffer_end,1);
            }

            /* enter typewriter mode */
            qwerty_output_buffer_just = 0;
          } /* if (rcv_byte == '0') */
          else if (rcv_byte == '1')
          {
            // justification: center
            if (qwerty_output_buffer_just == 1)
            {
              continue;
            }

            if (qwerty_output_buffer_just == 2)
            {
              /* turn off right justification : press CODE + O */
              qwerty_output_buffer[qwerty_output_buffer_end].val = 0x00a4 | KEYBOARD_CODE;
              INC_BUFFER_IDX(qwerty_output_buffer_end,1);
            }

            /* turn on center justification : press CODE + C */
            qwerty_output_buffer[qwerty_output_buffer_end].val = 0x0066 | KEYBOARD_CODE;
            INC_BUFFER_IDX(qwerty_output_buffer_end,1);

            qwerty_output_buffer_just = 1;
          } /* if (rcv_mode == '1') */
          else if (rcv_byte == '2')
          {
            // justification: right flush
            if (qwerty_output_buffer_just == 2)
            {
              continue;
            }

            if (qwerty_output_buffer_just == 1)
            {
              /* turn on center justification : press CODE + C */
              qwerty_output_buffer[qwerty_output_buffer_end].val = 0x0066 | KEYBOARD_CODE;
              INC_BUFFER_IDX(qwerty_output_buffer_end,1);
            }

            /* turn on right justification : press CODE + O */
            qwerty_output_buffer[qwerty_output_buffer_end].val = 0x00a4 | KEYBOARD_CODE;
            INC_BUFFER_IDX(qwerty_output_buffer_end,1);

            qwerty_output_buffer_just = 2;
          } /* if (rcv_mode == '2') */

        }  /* if (iwait_esc_just) */

        continue;
      } /* if (qwerty_output_buffer_esc_received == 2) */

      if (qwerty_output_buffer_esc_received == 3)
      {
        qwerty_output_buffer_esc_received = 0;

        if (iwait_esc_term_set == 3)
        {
          iwait_esc_term_set = 0;

          if (rcv_byte == '~')
          {
            // DEL
            qwerty_output_buffer[qwerty_output_buffer_end].val = 0x00d7;
            INC_BUFFER_IDX(qwerty_output_buffer_end,1);
          }
          continue;
        }

      } /* if (qwerty_output_buffer_esc_received == 3) */

      if (rcv_byte == 8)
      {
        //
        // BS received
        //
        qwerty_output_buffer[qwerty_output_buffer_end].val = 0x00c2;
        INC_BUFFER_IDX(qwerty_output_buffer_end,1);
        continue;
      }

      if (rcv_byte == 9)
      {
        //
        // TAB received
        //
        qwerty_output_buffer[qwerty_output_buffer_end].val = 0x00d4;
        INC_BUFFER_IDX(qwerty_output_buffer_end,1);
        continue;
      }

      if (rcv_byte == 13)
      {
        //
        // CR received
        //
        qwerty_output_buffer[qwerty_output_buffer_end].val = 0x00c0;
        INC_BUFFER_IDX(qwerty_output_buffer_end,1);

        /* check if we are in global justification modes: center or right flush */
        if (qwerty_output_buffer_just == 2)
        {
          /* Right FLush: press CODE + O (R Flsh) */
          qwerty_output_buffer[qwerty_output_buffer_end].val = 0x00a4 | KEYBOARD_CODE;
          INC_BUFFER_IDX(qwerty_output_buffer_end,1);
        }
        else if (qwerty_output_buffer_just == 1)
        {
          /* press CODE + C (Ctr) */
          qwerty_output_buffer[qwerty_output_buffer_end].val = 0x0066 | KEYBOARD_CODE;
          INC_BUFFER_IDX(qwerty_output_buffer_end,1);
        }

        continue;
      }

      if ( (rcv_byte > 31) && (rcv_byte < 128) )
      {
        //
        // ascii character received
        //
        symbol1.val = symbol[rcv_byte - 32].val;

        if (symbol1.val == KEYBOARD_UNSUPPORTED)
          continue;

        qwerty_output_buffer[qwerty_output_buffer_end].val = symbol1.val;
        INC_BUFFER_IDX(qwerty_output_buffer_end,1);

        if (qwerty_output_buffer_font_pitch == 0)
        {
          // 10CPI: space - 4*BKSP1
          qwerty_output_buffer[qwerty_output_buffer_end].val = 0x0037;
          INC_BUFFER_IDX(qwerty_output_buffer_end,1);
          qwerty_output_buffer[qwerty_output_buffer_end].val = 0x00c2 | KEYBOARD_CODE;
          INC_BUFFER_IDX(qwerty_output_buffer_end,1);
          qwerty_output_buffer[qwerty_output_buffer_end].val = 0x00c2 | KEYBOARD_CODE;
          INC_BUFFER_IDX(qwerty_output_buffer_end,1);
          qwerty_output_buffer[qwerty_output_buffer_end].val = 0x00c2 | KEYBOARD_CODE;
          INC_BUFFER_IDX(qwerty_output_buffer_end,1);
          qwerty_output_buffer[qwerty_output_buffer_end].val = 0x00c2 | KEYBOARD_CODE;
          INC_BUFFER_IDX(qwerty_output_buffer_end,1);
        }
        else if (qwerty_output_buffer_font_pitch == 2)
        {
          if (symbol1.val == 0x0037)
          {
            qwerty_output_buffer[qwerty_output_buffer_end].val = symbol1.val;
            INC_BUFFER_IDX(qwerty_output_buffer_end,1);
          }
          // 15CPI: BKSP1
          qwerty_output_buffer[qwerty_output_buffer_end].val = 0x00c2 | KEYBOARD_CODE;
          INC_BUFFER_IDX(qwerty_output_buffer_end,1);
        }

        continue;
      }


    } /*if (qwerty_typewriter_system_state == QWERTY_TYPEWRITER_SYSTEM_STATE_TYPEWRITER)*/

    if ( ((rcv_byte =='\r') || (rcv_byte =='\n') || (rcv_byte ==' ')
      || (rcv_byte ==';') ) && (len_cmd==0) )
      continue;

    usart2_rx_cmd_buffer[len_cmd] = rcv_byte;
    len_cmd++;
    if (len_cmd >= USART2_RX_CMD_BUFFER_SIZE-1)
    {
      len_cmd = 0;
      continue;
    }

    if ( (rcv_byte != '\r') && (rcv_byte != '\n') )
      continue;

    // terminate command buffer so that it is regular 0-terminated string
    usart2_rx_cmd_buffer[len_cmd] = '\0';

    idx_cmd=0;

_process_more:

    // sprintf(msg,"1:%lu:%lu\r\n",len_cmd,idx_cmd);
    // print_serial(msg);

    if (  *(usart2_rx_cmd_buffer+idx_cmd) == '\0'
      || (*(usart2_rx_cmd_buffer+idx_cmd) == '\n')
      || (*(usart2_rx_cmd_buffer+idx_cmd) == '\r') )
    {
      // print_serial("_p:exit\r\n");
      goto _process_more;
    }

    // print_serial("2\r\n");
    // gobble
    if ( (*(usart2_rx_cmd_buffer+idx_cmd) == '?')
      || (*(usart2_rx_cmd_buffer+idx_cmd) == ' ')
      || (*(usart2_rx_cmd_buffer+idx_cmd) == ';') )
    {
      idx_cmd++;
      goto _process_more;
    }

    // check usart2_rx_cmd_buffer
    // PWM:
    if (strlen(usart2_rx_cmd_buffer+idx_cmd) < 4)
      goto _exit;

    if (!strncmp(usart2_rx_cmd_buffer+idx_cmd,"print", 5))
    {
      qwerty_typewriter_system_state = QWERTY_TYPEWRITER_SYSTEM_STATE_TYPEWRITER;

      print_serial("Starting print operation: Send 0x0000 to exit!\r\n");

      goto _exit;

    } /*if (!strncmp(usart2_rx_cmd_buffer+idx_cmd,"type", 4))*/

    if (!strncmp(usart2_rx_cmd_buffer+idx_cmd,"sys:", 4))
    {
      idx_cmd += 4;

      // gobble up spaces
      while(*(usart2_rx_cmd_buffer+idx_cmd) == ' ')
      {
        idx_cmd++;
        if (*(usart2_rx_cmd_buffer+idx_cmd) == '\0')
          goto _exit;
        if (*(usart2_rx_cmd_buffer+idx_cmd) == ';')
          goto _process_more;
      }

      if (!strncmp(usart2_rx_cmd_buffer+idx_cmd,"mode", 4))
      {
        idx_cmd += 4;

        GOBBLESPACES;

        if (*(usart2_rx_cmd_buffer+idx_cmd) == 'p')
        {
          idx_cmd++;

          if ( (qwerty_tim3_oc_mode   == QWERTY_MODE_INVERTED)
            && (mux_it_mode           == QWERTY_MODE_INVERTED) )
          {
            qwerty_tim3_oc_mode   = QWERTY_MODE_POSITIVE;
            mux_it_mode           = QWERTY_MODE_POSITIVE;
            goto _restart;
          }
        }

        if (*(usart2_rx_cmd_buffer+idx_cmd) == 'i')
        {
          idx_cmd++;
          if ( (qwerty_tim3_oc_mode   == QWERTY_MODE_POSITIVE)
            && (mux_it_mode           == QWERTY_MODE_POSITIVE) )
          {
            qwerty_tim3_oc_mode    = QWERTY_MODE_INVERTED;
            mux_it_mode            = QWERTY_MODE_INVERTED;
            goto _restart;
          }
        }
      }

    } /* if (!strncmp(usart2_rx_cmd_buffer+idx_cmd,"sys:", 4)) */

    // if (strlen(usart2_rx_cmd_buffer+idx_cmd) < 5)
    //   goto _exit;

    if (!strncmp(usart2_rx_cmd_buffer+idx_cmd,"meas:", 5))
    {
      idx_cmd += 5;

      if (strlen(usart2_rx_cmd_buffer+idx_cmd) < 4)
        goto _exit;

      if (!strncmp(usart2_rx_cmd_buffer+idx_cmd,"mode", 4))
      {
        idx_cmd += 4;

        GOBBLESPACES;

        if (*(usart2_rx_cmd_buffer+idx_cmd) == '?')
        {
          idx_cmd++;
          if (qwerty_tim3_oc_mode == TIM3_OC_MODE_POSITIVE)
            sprintf(msg,"pos\r\n");
          else
            sprintf(msg,"inv\r\n");
          print_serial(msg);
          goto _process_more;
        }

        if (*(usart2_rx_cmd_buffer+idx_cmd) == 'p')
        {
          idx_cmd++;
          qwerty_tim3_oc_new_mode = TIM3_OC_MODE_POSITIVE;

          if (qwerty_tim3_oc_new_mode == qwerty_tim3_oc_mode)
            goto _process_more;

          qwerty_tim3_oc_mode = qwerty_tim3_oc_new_mode;
          qwerty_tim3_oc_it_edge_lead  = TIM_INPUTCHANNELPOLARITY_RISING;
          qwerty_tim3_oc_it_edge_trail = TIM_INPUTCHANNELPOLARITY_FALLING;
          edge1=0;
          edge2=0;
          IC_Value1 = 0;
          IC_Value2 = 0;
          previous_IC_Value1 = 0;
          previous_IC_Value2 = 0;
          HAL_TIM_Base_MspDeInit(&htim3);
          MX_TIM3_Init();
          // HAL_TIM_IC_Start_DMA(&htim3, TIM_CHANNEL_1,(uint32_t*)&IC_Value1,1);
          HAL_TIM_IC_Start_IT (&htim3, TIM_CHANNEL_1);
          HAL_TIM_IC_Start_IT (&htim3, TIM_CHANNEL_2);
        }
        else if (*(usart2_rx_cmd_buffer+idx_cmd) == 'i')
        {
          idx_cmd++;
          qwerty_tim3_oc_new_mode = TIM3_OC_MODE_INVERTED;

          if (qwerty_tim3_oc_new_mode == qwerty_tim3_oc_mode)
            goto _process_more;

          qwerty_tim3_oc_mode = qwerty_tim3_oc_new_mode;
          qwerty_tim3_oc_it_edge_lead  = TIM_INPUTCHANNELPOLARITY_FALLING;
          qwerty_tim3_oc_it_edge_trail = TIM_INPUTCHANNELPOLARITY_RISING;
          edge1=0;
          edge2=0;
          IC_Value1 = 0;
          IC_Value2 = 0;
          previous_IC_Value1 = 0;
          previous_IC_Value2 = 0;
          HAL_TIM_Base_MspDeInit(&htim3);
          MX_TIM3_Init();
          HAL_TIM_IC_Start_IT (&htim3, TIM_CHANNEL_1);
          HAL_TIM_IC_Start_IT (&htim3, TIM_CHANNEL_2);
          // HAL_TIM_IC_Start_DMA(&htim3, TIM_CHANNEL_1,(uint32_t*)&IC_Value1,1);
        }

        goto _process_more;
      }

      if (!strncmp(usart2_rx_cmd_buffer+idx_cmd,"ch1?", 4))
      {
        idx_cmd += 4;
        snprintf(msg,64, "%lu,%lu,0\r\n", period1, pulse1);
        print_serial(msg);
        period1 = 0;
        pulse1 = 0;
        // sprintf(msg,"%lu,%lu,0\r\n",period1,pulse1);
        goto _process_more;
      }

      if (!strncmp(usart2_rx_cmd_buffer+idx_cmd,"ch1:", 4))
      {
        idx_cmd += 4;

        if (strlen(usart2_rx_cmd_buffer+idx_cmd) < 5)
          goto _exit;

        if (!strncmp(usart2_rx_cmd_buffer+idx_cmd,"pulse", 5))
        {
          idx_cmd += 5;
          sprintf(msg,"%lu\r\n",pulse1);
          print_serial(msg);
          if (*(usart2_rx_cmd_buffer+idx_cmd) == '\0')
          {
            goto _exit;
          }
          goto _process_more;

        } /* if (!strncmp(usart2_rx_cmd_buffer+idx_cmd,"pulse", 5)) */
        else if (!strncmp(usart2_rx_cmd_buffer+idx_cmd,"delay", 5))
        {
          idx_cmd += 5;
          print_serial("0\r\n");
          if (*(usart2_rx_cmd_buffer+idx_cmd) == '\0')
          {
            goto _exit;
          }
          goto _process_more;

        } /* if (!strncmp(usart2_rx_cmd_buffer+idx_cmd,"pulse", 5)) */

        if (strlen(usart2_rx_cmd_buffer+idx_cmd) < 6)
          goto _exit;
        if (!strncmp(usart2_rx_cmd_buffer+idx_cmd,"period", 6))
        {
          idx_cmd += 6;
          sprintf(msg,"%lu\r\n",period1);
          print_serial(msg);
          if (*(usart2_rx_cmd_buffer+idx_cmd) == '\0')
          {
            goto _exit;
          }
          goto _process_more;

        } /* if (!strncmp(usart2_rx_cmd_buffer+idx_cmd,"period", 6)) */

      }

      if (!strncmp(usart2_rx_cmd_buffer+idx_cmd,"ch2?", 4))
      {
        idx_cmd += 4;
        sprintf(msg,"%lu,%lu,%lu\r\n",period2,pulse2,delay2);
        print_serial(msg);
        period2 = 0;
        pulse2 = 0;
        delay2 = 0;

        goto _process_more;
      }

      if (!strncmp(usart2_rx_cmd_buffer+idx_cmd,"ch2:", 4))
      {
        idx_cmd += 4;

        if (strlen(usart2_rx_cmd_buffer+idx_cmd) < 5)
          goto _exit;

        if (!strncmp(usart2_rx_cmd_buffer+idx_cmd,"pulse", 5))
        {
          idx_cmd += 5;
          sprintf(msg,"%lu\r\n",pulse2);
          print_serial(msg);
          if (*(usart2_rx_cmd_buffer+idx_cmd) == '\0')
          {
            goto _exit;
          }
          goto _process_more;

        } /* if (!strncmp(usart2_rx_cmd_buffer+idx_cmd,"pulse", 5)) */
        else if (!strncmp(usart2_rx_cmd_buffer+idx_cmd,"delay", 5))
        {
          idx_cmd += 5;
          sprintf(msg,"%lu\r\n",delay2);
          print_serial(msg);
          if (*(usart2_rx_cmd_buffer+idx_cmd) == '\0')
          {
            goto _exit;
          }
          goto _process_more;
        } /* if (!strncmp(usart2_rx_cmd_buffer+idx_cmd,"delay", 5)) */

        if (strlen(usart2_rx_cmd_buffer+idx_cmd) < 6)
          goto _exit;
        if (!strncmp(usart2_rx_cmd_buffer+idx_cmd,"period", 6))
        {
          idx_cmd += 6;
          sprintf(msg,"%lu\r\n",period2);
          print_serial(msg);
          if (*(usart2_rx_cmd_buffer+idx_cmd) == '\0')
          {
            goto _exit;
          }
          goto _process_more;
        }
      }
    }

    if (!strncmp(usart2_rx_cmd_buffer+idx_cmd,"drive:burst", 11))
    {
      idx_cmd += 9;

      if (strlen(usart2_rx_cmd_buffer+idx_cmd) < 1)
        goto _exit;

      GOBBLESPACES;

      qwerty_output_counter_new = atoi(usart2_rx_cmd_buffer+idx_cmd);
      if (qwerty_output_counter_new < QWERTY_OUTPUT_COUNTER_DEFAULT)
      {
        qwerty_output_counter_new = QWERTY_OUTPUT_COUNTER_DEFAULT;
      }
      if (qwerty_output_counter_new != qwerty_output_counter_default)
      {
        qwerty_output_counter_default = qwerty_output_counter_new;
      }

      GOBBLEDIGITS;

    } /*if (!strncmp(usart2_rx_cmd_buffer+idx_cmd,"drive:burst", 9))*/

    if ( *(usart2_rx_cmd_buffer+idx_cmd) == 'd' )
    {
      idx_cmd += 1;

      if (strlen(usart2_rx_cmd_buffer+idx_cmd) < 1)
        goto _exit;

      /**
        * d{0:9,a:d} for d{0:13} but with respect to drive S3
        */
      idx_drive_ch_new = *(usart2_rx_cmd_buffer+idx_cmd) - '0';
      if (idx_drive_ch_new < 0)
      {
        print_serial("Drive Channel out of bounds! Err.\r\n");
        goto _exit;
      }
      if (idx_drive_ch_new > 9)
      {
        idx_drive_ch_new += '0' - 'a' + 10;
        if (idx_drive_ch_new > 13)
        {
          print_serial("Drive Channel out of bounds! Err.\r\n");
          goto _exit;
        }
      }

      idx_cmd += 1;

      if ( *(usart2_rx_cmd_buffer+idx_cmd) != 's' )
        goto _exit;

      idx_cmd += 1;

      idx_sense_ch_new = atoi(usart2_rx_cmd_buffer+idx_cmd);
      if ( (idx_sense_ch_new < 0)
        || (idx_sense_ch_new > 7) )
      {
        print_serial("Sense Channel out of bounds! Err.\r\n");
        goto _exit;
      }

      // update registers
      while (qwerty_typing){;}

      qwerty_count_typed_characters++;

      if (idx_drive_ch_new < 7)
      {
        idx_drive_ch_new--;

        qwerty_tim14_oc_ccr  = qwerty_pulse_ccr_drive [idx_drive_ch_new];
        qwerty_tim14_oc_arr  = qwerty_pulse_arr_drive [idx_drive_ch_new];
        qwerty_tim14_oc_arr2 = qwerty_pulse_arr2_drive[idx_drive_ch_new];

        qwerty_output_counter1_have_update = 1;
        qwerty_output_counter2_have_update = 0;
        while (qwerty_output_counter1_have_update){;}
      }
      else
      {
        // idx_drive_ch_new -= 7; /* this one doesnt change: it is fixed at 7 */
        idx_drive_ch_new -= 4;
        idx_drive_ch_new--;

        // At CCR the pulse starts
        qwerty_tim14_oc_ccr  = qwerty_pulse_ccr_drive [idx_drive_ch_new];
        qwerty_tim14_oc_arr  = qwerty_pulse_arr_drive [idx_drive_ch_new];
        qwerty_tim14_oc_arr2 = qwerty_pulse_arr2_drive[idx_drive_ch_new];

        qwerty_output_counter1_have_update = 0;
        qwerty_output_counter2_have_update = 1;
        while (qwerty_output_counter2_have_update){;}
      }

      GOBBLEDIGITS;

      GOBBLESPACES;

    } /*if (!strncmp(usart2_rx_cmd_buffer+idx_cmd,"s", 1))*/

_exit:

    // print_serial("exit\r\n");
    len_cmd = 0;

  } /* while (1) */

  // print_serial("END\r\n");
  /* USER CODE END 3 */
}

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
