mkostrun/QWERTY/ibm-wheelwriter_1000/f030r8-qwerty-ibm-ww1000-07-pitch_brute_force/Core/Inc/main.h

#define TYPEWRITER_FIRMWARE_VERSION "7.0"
#define TYPEWRITER_MFG    "IBM"
#define TYPEWRITER_MODEL  "WheelWriter 1000"
#define QWERTY_OUTPUT_BUFFER_LENGTH (512L)
#define QWERTY_TYPEWRITER_SYSTEM_STATE_TYPEWRITER (1)
#define QWERTY_TYPEWRITER_SYSTEM_STATE_CLI        (0)
#define QWERTY_TYPEWRITER_SYSTEM_STATE_DEFAULT    QWERTY_TYPEWRITER_SYSTEM_STATE_TYPEWRITER
#define QWERTY_OUTPUT_COUNTER_DEFAULT             (2L)
#define QWERTY_MIN_BASE_PULSES_BETWEEN_CHARACTERS (5L)
#define QWERTY_INDEX_DRIVE_SPLIT (7)   /* 7 for: {0:6}, {7:d} per original design */
#define QWERTY_PITCH_SWITCH_MODE_ANALOG           (0L)
#define QWERTY_PITCH_SWITCH_MODE_DIGITAL          (1L)
#define QWERTY_PITCH_SWITCH_MODE QWERTY_PITCH_SWITCH_MODE_ANALOG
#define TIM14_DELTA_FUDGE_ARR (-7000)
#define TIM14_DELTA_FUDGE_CCR (-7000)
#define QWERTY_MODE_POSITIVE                      (0x01)
#define QWERTY_MODE_INVERTED                      (0x00)
#define B1_Pin GPIO_PIN_13
#define B1_GPIO_Port GPIOC
#define USART_TX_Pin GPIO_PIN_2
#define USART_TX_GPIO_Port GPIOA
#define USART_RX_Pin GPIO_PIN_3
#define USART_RX_GPIO_Port GPIOA
#define LD2_Pin GPIO_PIN_5
#define LD2_GPIO_Port GPIOA
#define TMS_Pin GPIO_PIN_13
#define TMS_GPIO_Port GPIOA
#define TCK_Pin GPIO_PIN_14
#define TCK_GPIO_Port GPIOA
#define GOBBLESPACES {\
#define GOBBLEDIGITS {\
