mkostrun/QWERTY/ibm-wheelwriter_1000/f030r8-qwerty-ibm-ww1000-07-pitch_brute_force/Core/Inc/tim.h

#ifndef __tim_H
#define __tim_H

#define   TIM3_OC_MODE_POSITIVE (1)
#define   TIM3_OC_MODE_INVERTED (0)


/* Private variables ---------------------------------------------------------*/

extern TIM_HandleTypeDef htim3;
extern TIM_HandleTypeDef htim14;
extern TIM_HandleTypeDef htim16;
extern DMA_HandleTypeDef hdma_tim3_ch3;
extern DMA_HandleTypeDef hdma_tim3_ch4_up;

void HAL_TIM3_Base_MspInit    (TIM_HandleTypeDef* htim_base);
void HAL_TIM3_MspPostInit     (TIM_HandleTypeDef* timHandle);
void HAL_TIM_Base_MspPostInit (TIM_HandleTypeDef* htim_base);
void HAL_TIM_Base_MspDeInit   (TIM_HandleTypeDef* htim_base);

extern void MX_TIM3_Init(void);
extern uint32_t           qwerty_tim_base_prescaler;
extern volatile uint8_t   qwerty_tim3_oc_mode, qwerty_tim3_oc_new_mode;
extern volatile uint32_t  qwerty_tim3_oc_it_edge_lead, qwerty_tim3_oc_it_edge_trail;

extern volatile uint8_t edge1;
extern volatile uint8_t edge2;
extern volatile uint32_t IC_Value1;
extern volatile uint32_t IC_Value2;
extern volatile uint32_t previous_IC_Value1;
extern volatile uint32_t previous_IC_Value2;
extern volatile uint32_t counter;
extern volatile uint32_t period1;
extern volatile uint32_t period1_safe;
extern volatile uint32_t pulse1;
extern volatile uint32_t period2;
extern volatile uint32_t period2_safe;
extern volatile uint32_t pulse2;
extern volatile uint32_t delay2;



#endif
