mkostrun/QWERTY/(commit log)

2026-07-17 Update README.md to include Pitch Switch with AIM
2026-07-17 Add README for pitch switch brute force method
2026-07-17 Update print statement from 'Hello' to 'Goodbye'
